Mahagon/esphome-zaehlerecke/README.md

# ESPHome Zählerecke

Ein ESP32-DevKit liest den Gaszähler und den Hauptwasserzähler aus und schickt die Zählerstände an Home Assistant.

| Zähler | Sensor | Auflösung |
| --- | --- | --- |
| Gas, Apator Metrix G4 | Reedkontakt MK04 an der letzten Ziffernrolle | 1 Impuls = 0,01 m³ |
| Wasser, Ernst Heitland (Q3 = 4) | TCRT5000 über dem schwarzen Sternrad | 1 Zacken ≈ 38,6 mL (26 pro L) |

## Verdrahtung

Verdrahtungsplan

- Der Reedkontakt hat keine Polarität. GPIO27 nutzt den internen Pull-up: offen liest der Pin HIGH, geschlossen LOW. Einen externen Widerstand braucht es nicht.
- Vom TCRT5000 wird nur der analoge Ausgang A0 gebraucht. Der Komparator-Ausgang D0 hat keine Hysterese und flattert, wenn das Sternrad langsam dreht. Die Hysterese macht stattdessen ESPHome.
- Das DevKit hat mehrere GND-Pins, beide Sensoren können also je einen eigenen nehmen. Alles lässt sich mit Dupont-Kabeln oder Wago-Klemmen stecken, ohne zu löten.
- Die Kabelfarben sind ein Vorschlag: Rot für VCC, Schwarz für GND, Gelb für das Signal.
- Strom bekommt das Board über USB von einem 5-V/1-A-Netzteil.

Der Plan steht in `docs/verdrahtung.yaml` und wird mit [WireViz](https://github.com/wireviz/WireViz) gezeichnet. Nach einer Änderung das Bild so neu erzeugen:

```bash
podman build -t localhost/wireviz:0.4.1 -f docs/wireviz.Containerfile docs
podman run --rm --userns=keep-id -v "$PWD/docs":/data:Z localhost/wireviz:0.4.1 -f s verdrahtung.yaml
```

## Einrichtung

Zuerst die Vorlage für die Secrets kopieren und ausfüllen. Den API-Schlüssel erzeugt `openssl`:

```bash
cp secrets.yaml.example secrets.yaml
openssl rand -base64 32   # Ergebnis bei api_key_zaehlerecke eintragen
```

Beim ersten Mal wird per USB geflasht. Dafür muss der eigene Benutzer in der Gruppe `dialout` sein. Auf Systemen mit SELinux (z. B. Fedora) darf ein Container die serielle Schnittstelle außerdem nur mit `--security-opt label=disable` öffnen. Sonst meldet ESPHome fehlende Rechte, obwohl die Gruppe stimmt:

```bash
podman run --rm -it -v "$PWD":/config:Z --device /dev/ttyUSB0 --group-add keep-groups \
  --security-opt label=disable \
  ghcr.io/esphome/esphome:2026.10.2 run zaehlerecke.yaml --device /dev/ttyUSB0
```

Danach gehen Updates über WLAN. Mit `logs` statt `run` zeigt ESPHome nur das Log an:

```bash
podman run --rm -it --network host -v "$PWD":/config:Z ghcr.io/esphome/esphome:2026.10.2 run  zaehlerecke.yaml --device <IP>
podman run --rm -it --network host -v "$PWD":/config:Z ghcr.io/esphome/esphome:2026.10.2 logs zaehlerecke.yaml --device <IP>
```

## Druckteile

Die Halter und das Gehäuse liegen als Python-Generatoren in `cad/`. Sie erzeugen SolidCraft-Skripte, aus denen `solidcraft-cli` die STL-Dateien und ein parametrisches Design (`.sc`) baut. Alle Teile neu bauen:

```bash
cad/build.sh
```

- `gas_halter`: Stopfen für den geöffneten Impulsgeber-Schacht des Gaszählers mit Tasche für den MK04. `gas_halter_test` ist nur der Kragen mit einem kurzen Stück Stopfen, um die Passung zu prüfen. Druck in PETG, weil PLA unter Klemmkraft nachgibt.
- `esp_schale`, `esp_deckel`, `esp_wandhalter`: Gehäuse für das ESP32, die Schale wird von oben auf den Wandhalter geschoben. `esp_schale_45` ist die Schale um 45° gekippt mit eigenen Stützen, dafür in Cura die Stützen ausschalten. `esp_schwalbe_test` prüft die Passung der Schiene.
- `wasser_haube_stern`: Haube für den TCRT5000 am Wasserzähler, Tellerseite auf dem Bett, schwarzes PLA+.

Wer ein Teil in SolidCraft von Hand ändert, sollte die Änderung auch in den Generator übernehmen. `cad/build.sh` überschreibt sonst die `.sc` und `.stl`.

## Wasser kalibrieren

Den roten Zeiger sieht der TCRT5000 nicht, weil Rot im Infrarot so hell ist wie das weiße Zifferblatt. Deshalb schaut er auf das schwarze Sternrad. Die Haube hält den Sensor direkt auf dem Glas. Mit Luft dazwischen spiegelt das Glas zu viel Licht zurück. Die Haube so drehen, dass das Fenster etwa 3 mm neben der Mitte des Sternrads über den Zacken liegt, und die Stellung auf Haube und Ring markieren.

1. In Home Assistant „Wasser Sensor Min (2s)“ und „Wasser Sensor Max (2s)“ ablesen, einmal bei stehendem und einmal bei laufendem Wasser. Bei laufendem Wasser müssen die beiden deutlich weiter auseinanderliegen als im Stillstand. Gemessen waren 0,08 V gegen 0,016 V Rauschen.
2. Die Schwellen ausrechnen, in `zaehlerecke.yaml` eintragen und per OTA flashen:
   - `water_main_threshold_upper` = Min + 0,7 × (Max − Min)
   - `water_main_threshold_lower` = Min + 0,3 × (Max − Min)

   Der Abstand zwischen den Schwellen muss deutlich größer sein als das Rauschen im Stillstand. Sonst zählt ein Sternrad, das auf einer Kante stehen bleibt, immer wieder.
3. Die Menge pro Zacken gegen den Zähler selbst bestimmen, nicht mit einem Messbecher: Haube abnehmen, die Zeiger fotografieren, Haube aufsetzen, einige Liter langsam und einige voll aufgedreht laufen lassen, Haube abnehmen, wieder fotografieren. Danach gilt:

   `water_main_ul_per_pulse` neu = alt × (Verbrauch laut Zeigern / Verbrauch laut Home Assistant)

   Dieselbe Rechnung passt auch zum Nachjustieren nach ein paar Tagen, mit dem Zählerstand statt der Zeiger. Gemessen sind bisher etwa 38 600 µL pro Impuls, auf etwa 4 % genau.

## Zählerstände

Den aktuellen Stand einmal am Zähler ablesen und in „Gas Zählerstand setzen“ bzw. „Wasser Zählerstand setzen“ eintragen. Erst danach die Sensoren ins Energie-Dashboard aufnehmen. Andersherum hält Home Assistant den Sprung von 0 auf den echten Stand für Verbrauch.
