Mahagon/esphome-zaehlerecke/cad/wasser_haube_stern.stl

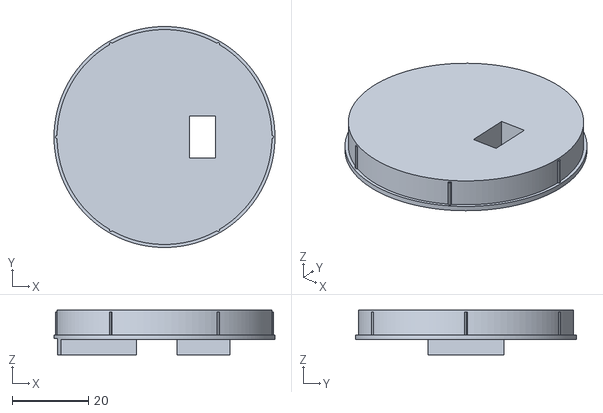
[picture p1: CAD file, 2026-11-12]
cad/wasser_haube_stern.stl
58.0 x 58.0 x 11.8
