Mahagon/esphome-zaehlerecke/cad/gas_halter_test.stl

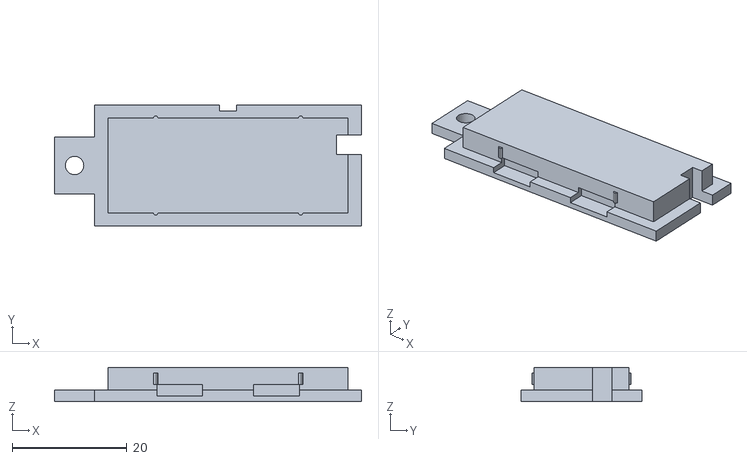
[picture p2: CAD file, 2026-11-12]
cad/gas_halter_test.stl
53.5 x 21.0 x 6.00
