Mahagon/esphome-zaehlerecke/cad/esp_schale.stl

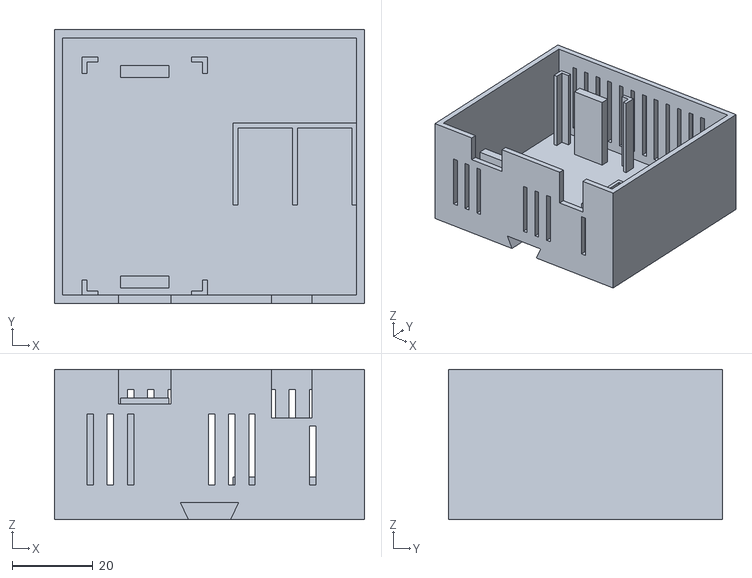
[picture p3: CAD file, 2026-11-12]
cad/esp_schale.stl
76.6 x 67.6 x 37.1
