Mahagon/esphome-zaehlerecke/cad/esp_deckel.stl

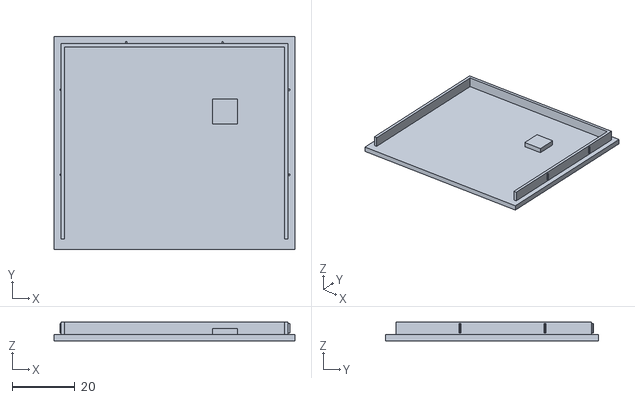
[picture p4: CAD file, 2026-11-12]
cad/esp_deckel.stl
76.6 x 67.6 x 5.99
