Mahagon/esphome-zaehlerecke/cad/esp_wandhalter.stl

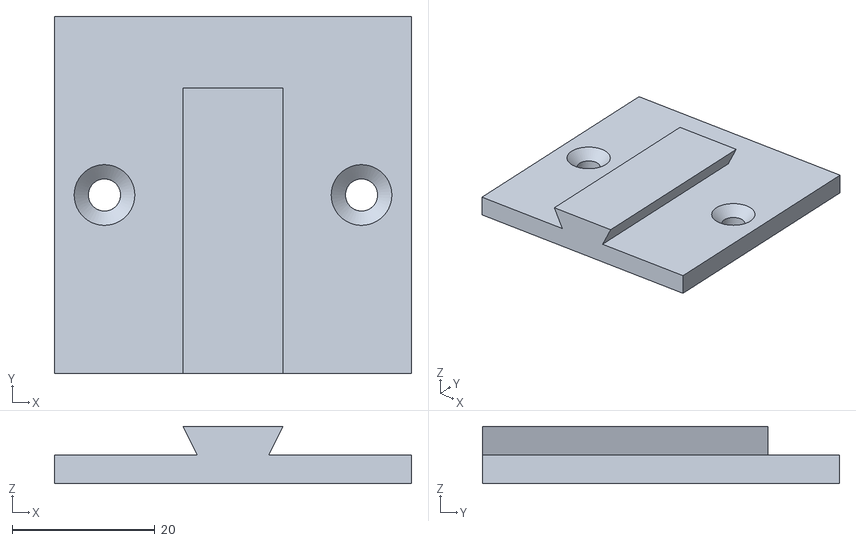
[picture p5: CAD file, 2026-11-12]
cad/esp_wandhalter.stl
50.0 x 50.0 x 8.00
