Mahagon/esphome-zaehlerecke/cad/esp_schwalbe_test.stl

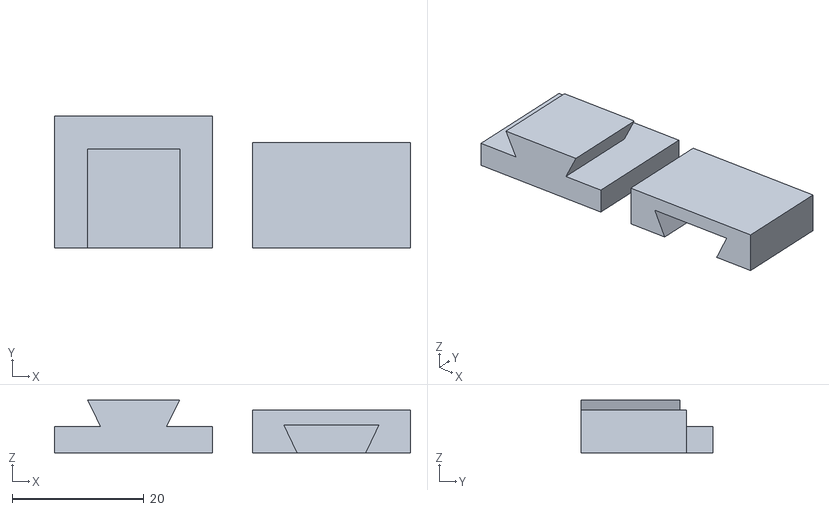
[picture p6: CAD file, 2026-11-12]
cad/esp_schwalbe_test.stl
54.0 x 20.0 x 8.00
