Mahagon/esphome-zaehlerecke/cad/gas_halter.stl

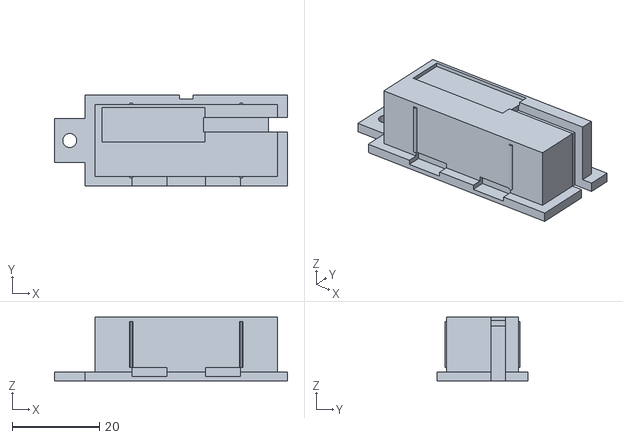
[picture p7: CAD file, 2026-11-12]
cad/gas_halter.stl
53.5 x 21.0 x 14.6
