Mahagon/esphome-zaehlerecke/cad/esp_schale_45.stl

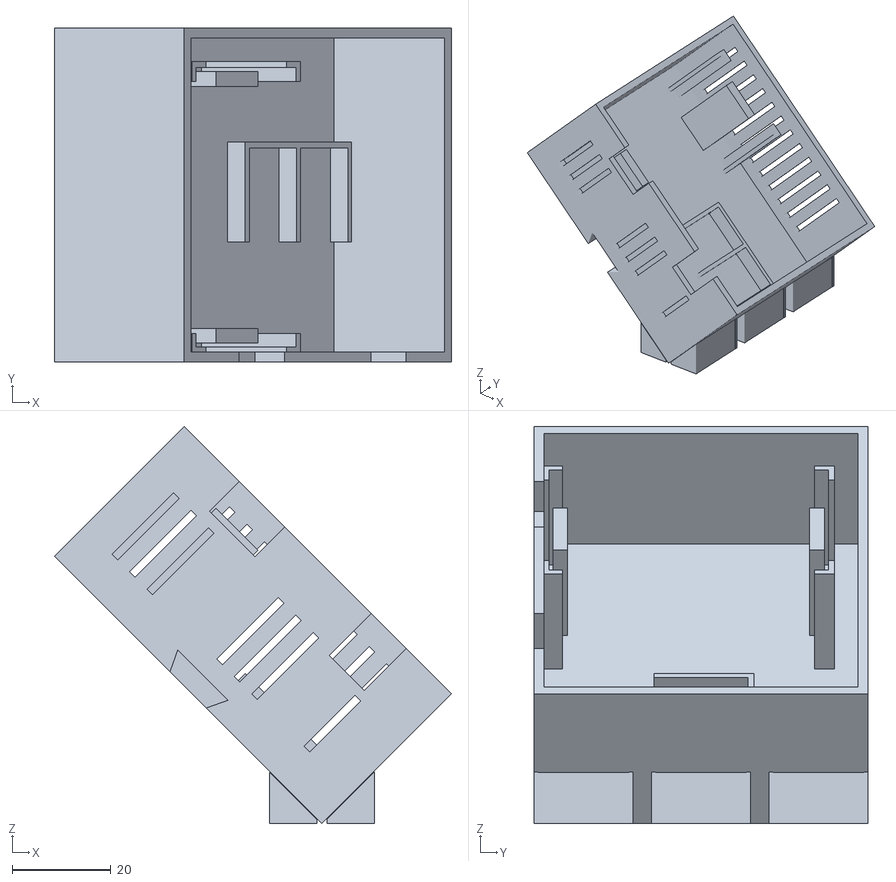
[picture p8: CAD file, 2026-11-12]
cad/esp_schale_45.stl
80.4 x 67.6 x 80.4
