Mahagon/esphome-zaehlerecke/(commit log)

2026-11-09 docs: add WireViz wiring diagram
    The ASCII sketch could not show wire colors and broke easily when
    edited. WireViz renders pin-to-pin wiring with colors from a YAML
    source, so the plan can be followed directly when plugging the
    Dupont cables. The Containerfile pins WireViz and Graphviz so the
    SVG can be rebuilt with Podman without host installs.
    [verdrahtung.yaml]
2026-11-09 chore: ignore WireViz font cache
    Rendering the wiring diagram with --userns=keep-id makes fontconfig
    write its cache to docs/.cache/, which must not end up in the repo.
2026-11-09 docs: fix USB flashing under SELinux
    Fedora's SELinux policy blocks containers from opening USB serial
    devices, so esphome run failed with a misleading dialout error even
    with the group set. label=disable lifts this for the flash container
    only.
2026-11-09 feat: encrypt OTA updates with the API key
    ESPHome warns that the OTA password wastes flash and RAM and only
    authenticates the upload. Encryption reuses the API key, so the
    firmware image is also confidential in transit and one key protects
    the device. Switched before the first flash, so no migration is
    needed.
2026-11-09 fix: merge double reed closures into one gas pulse
    At the edge of the magnet's field the reed switch can close twice
    during one pass, once per pole. A desk test produced two pulses
    0.7 s apart. delayed_off: 2s merges such closures; real pulses
    come at most every 6 s at the meter's 6 m³/h maximum.
2026-11-10 feat: add gas and water flow measurement with timeout handling
2026-11-12 chore: ignore SolidCraft backups and Python cache
    solidcraft-cli run --save keeps the previous design as *.sc.bak, and
    the CAD generators leave __pycache__ behind. Neither belongs in git.
2026-11-12 feat(cad): add reed switch holder for the gas meter
    The MK04 has to lie flat on the floor of the opened pulse sender
    shaft of the Metrix G4; taped onto the cover it is too far from the
    magnet. The plug clamps in the shaft, its collar fixes the depth and
    a groove leads the cable out to the right. A short test piece checks
    the fit before the full print.
    [gas_halter.stl, gas_halter_test.stl]
2026-11-12 feat(cad): add enclosure for the ESP32
    The board, Dupont wires and Wago clamps need a closed housing in the
    basement. The shell slides onto a screwed wall rail and lifts off with
    the cables still attached. A 45° variant with built-in breakaway
    supports prints without slicer supports.
    [esp_deckel.stl, esp_schale.stl, esp_schale_45.stl, esp_schwalbe_test.stl, esp_wandhalter.stl]
2026-11-12 feat(cad): add TCRT5000 hood for the water meter
    The red pointer is invisible in infrared, so the sensor looks at the
    black star wheel. It must sit directly on the glass: with 1 mm of air
    the glass mirrors the IR LED into the receiver and saturates it. The
    hood clamps in the meter ring, blocks ambient light and guides the
    sensor block in a tight window; it can be turned onto the star wheel.
    build.sh regenerates all printed parts.
    [wasser_haube_stern.stl]
2026-11-12 feat: count water at the star wheel via A0
    Over the star wheel A0 swings only about 0.08 V. The module's
    comparator (D0) has no hysteresis and chattered whenever the wheel
    turned slowly, so slow and full flow disagreed by a factor of 15.
    Oversampling the ADC (8 samples every 5 ms) cuts the noise to 0.016 V,
    and analog_threshold adds the missing hysteresis.
    Calibrated against the meter's pointers: 8.5 L gave 220 pulses, about
    38.6 mL per tooth. The counter runs in microlitres so the fraction is
    not lost on every pulse. Flow is derived from the pulses of the last
    10 s.
    [verdrahtung.yaml]
2026-11-12 docs: describe printed parts and current calibration
    The README said nothing about cad/ and still described the calibration
    steps for the abandoned pointer setup. It now lists the printed parts
    and how to rebuild them, and calibrates the star wheel against the
    meter's own pointers.
    GPIO35 was reserved for a second TCRT5000 at the garden meter. That
    meter only has digit rolls, so it will get the PM +m pulse module on
    GPIO33 instead, which has the internal pull-up a contact output needs.
